agarwita-ctrl/AgriSense/(commit log)

2026-10-07 Dockerfile: print MPM state and run configtest at build time
2026-10-07 Show trend on sensor history chart; default period Today
2026-10-08 Sensor history trend chart, Today default, ESP32 HTTPS support
2026-10-14 Add planting cycle: farmers set crop, start date and length; ESP32 pauses auto irrigation outside it
2026-11-09 Add Progressive Web App support: manifest, service worker, offline page, install button
    Static assets only are cached; /api, non-GET requests and HTML pages never are.
    Dashboard stops polling and flags data as not live while offline.
2026-11-09 Split soil probes into dry-zone (start) and wet-zone (stop) roles
    Firmware 4.3.0 starts watering on probe 1 and stops on probe 2; either probe
    lost blocks auto start and stops a running cycle. Server no longer averages
    two-probe readings or raises probe_mismatch; labels and docs updated.
2026-11-10 Add landing page: HomeController, landing views and styles
